loglow/T2M/README.md

See: https://forum.pjrc.com/threads/58795-T2M-an-Embeddable-Teensy-Module-(WIP)
