loglow/T2M/JTAG_Programmer_Assembly.pdf

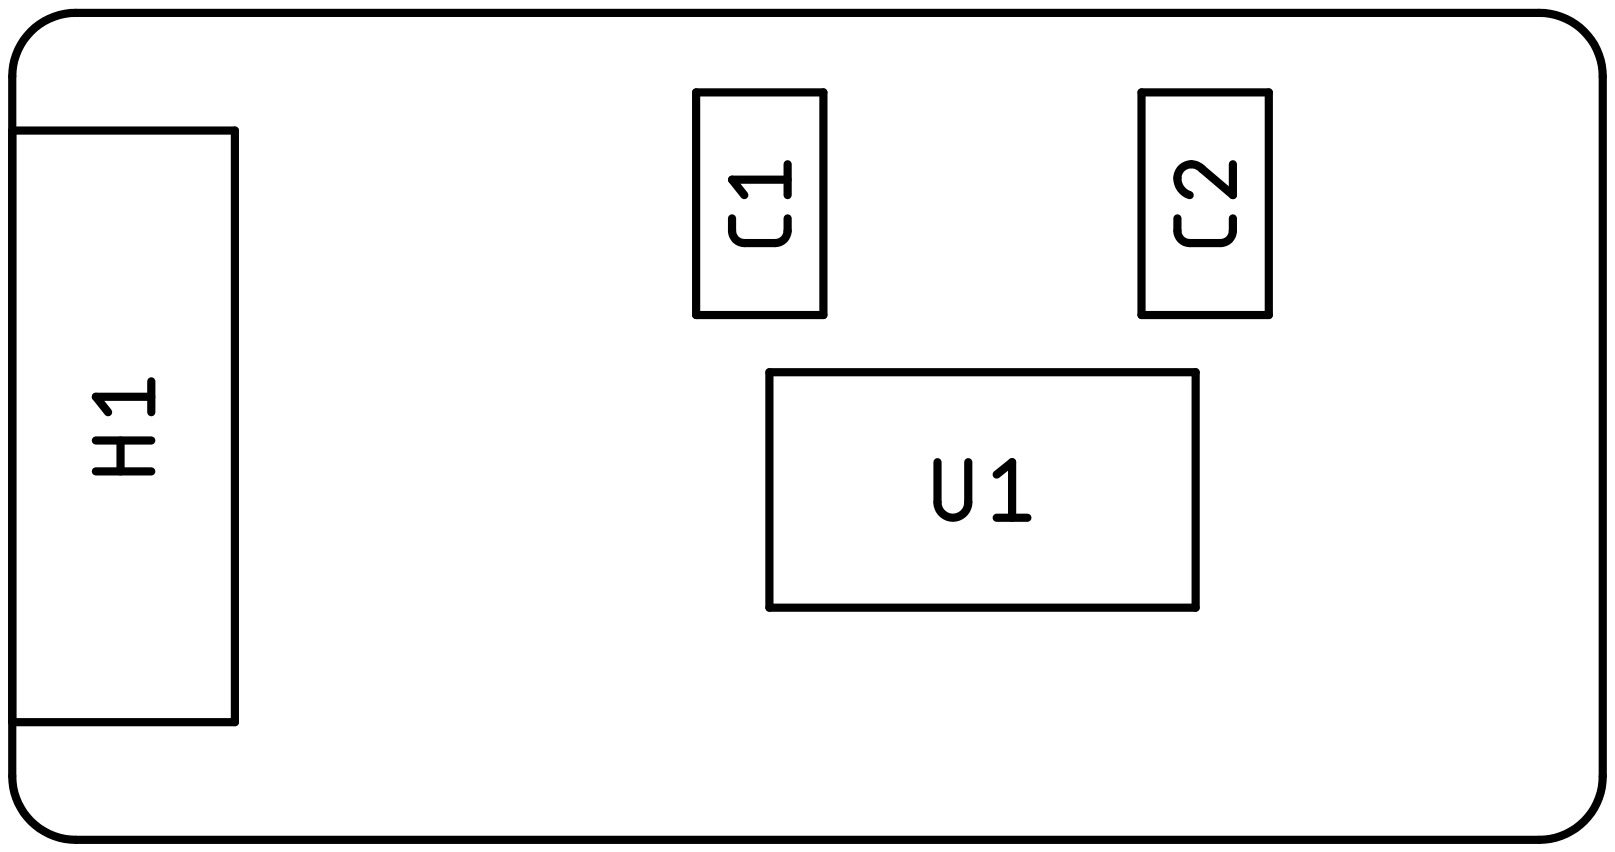
[picture p1: page 1]

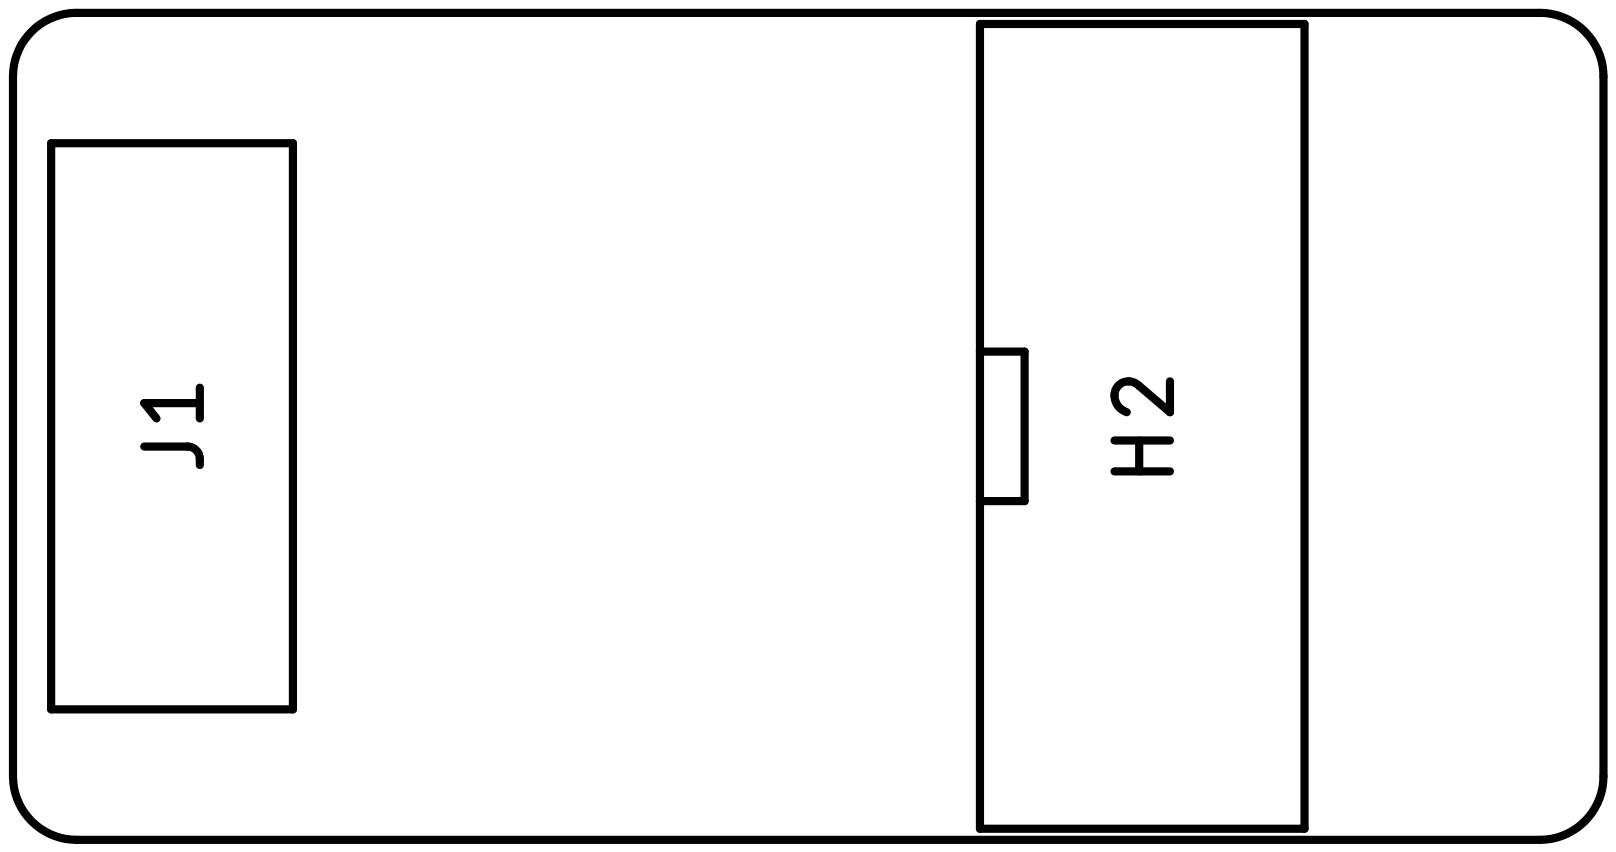
[picture p2: page 2]
