loglow/T2M/MKL02_Programmer_Assembly.pdf

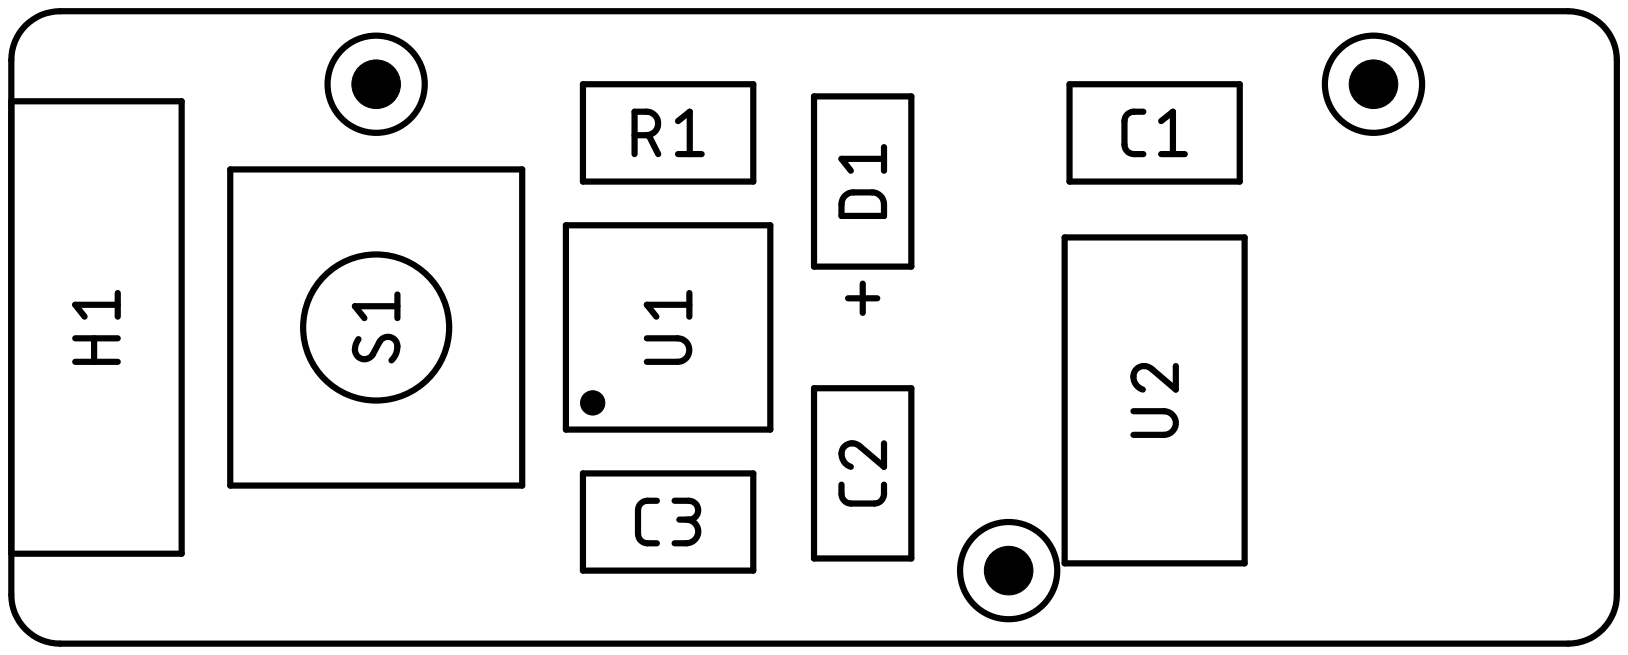
[picture p3: page 1]

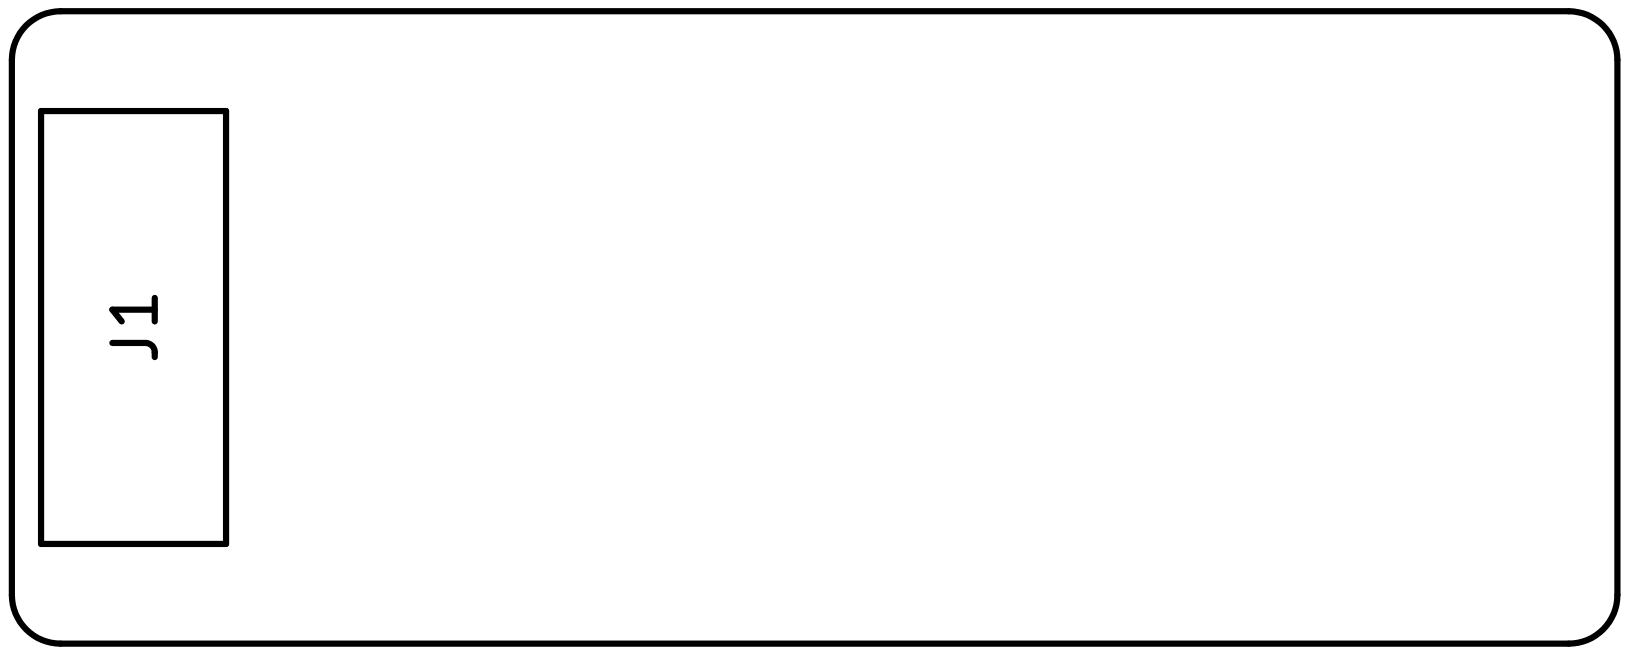
[picture p4: page 2]
