loglow/T2M/T2M_4_0_Assembly.pdf

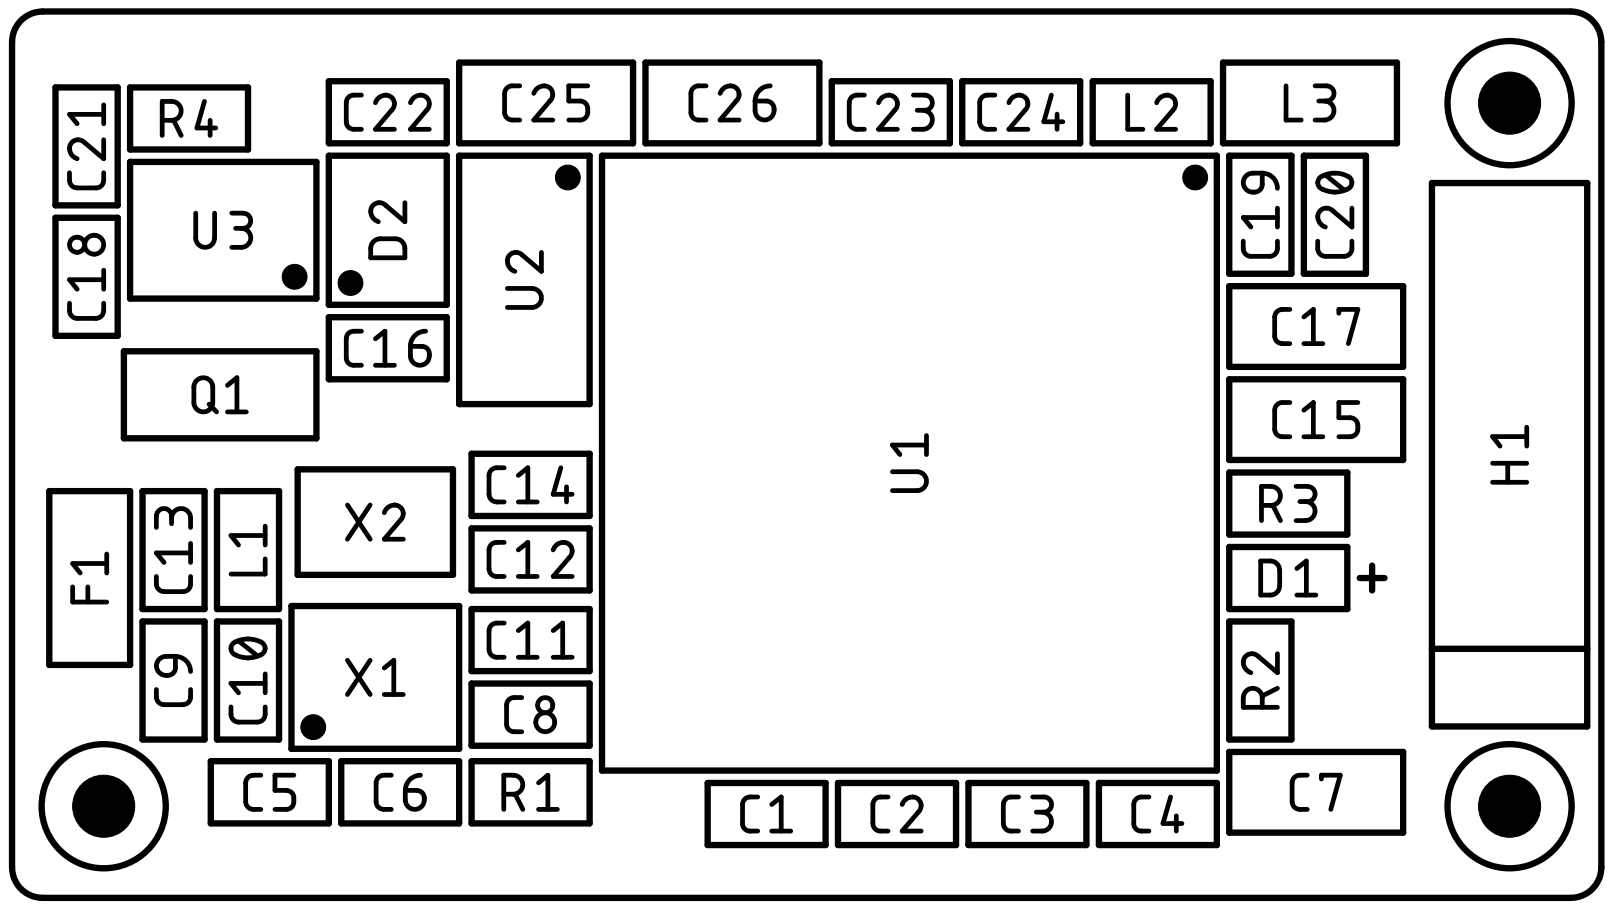
[picture p5: page 1]
