loglow/T2M/JTAG_Programmer.brd

## EAGLE design JTAG_Programmer.brd (2019-12-24)

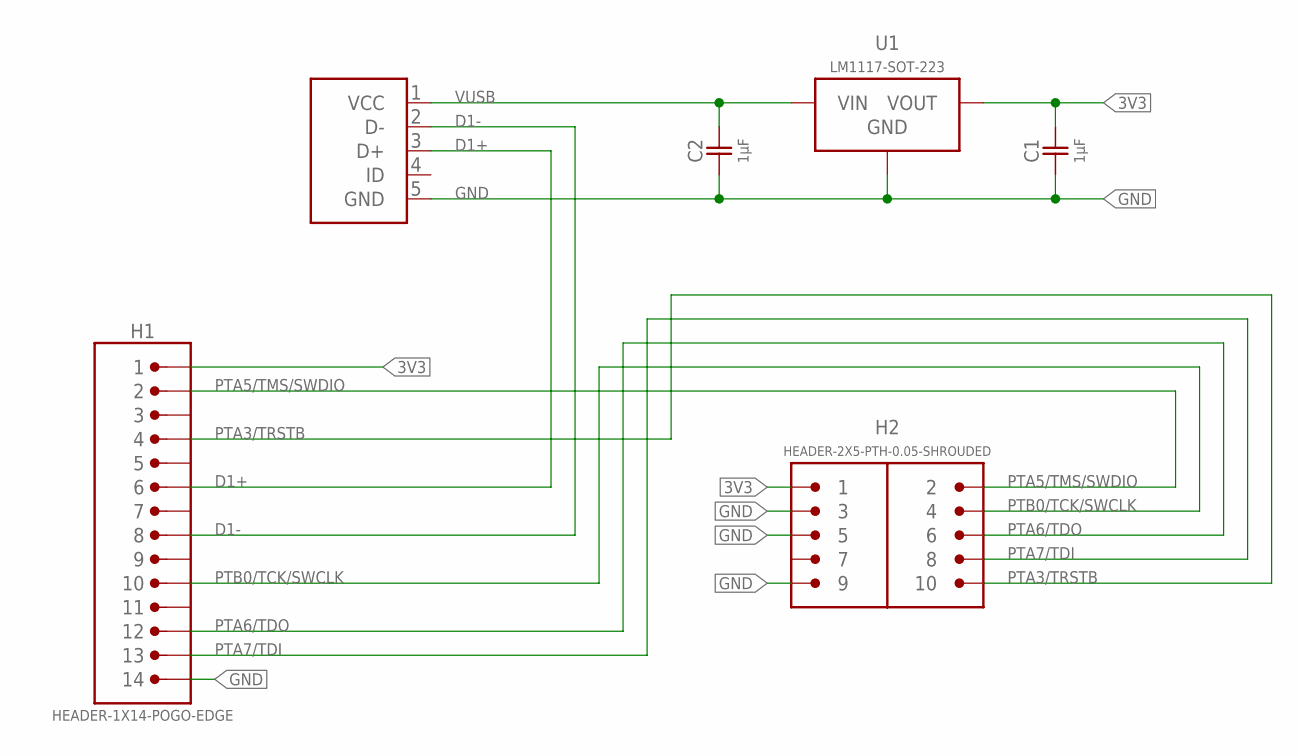
[picture p6: schematic JTAG_Programmer.sch]

Parts:
C1, C2: 1µF; 0805-NP
H1: HEADER-1X14-POGO-EDGE; 2X7-1.27MM-POGO-EDGE
H2: HEADER-2X5-PTH-0.05-SHROUDED; PTH-0.05-2X5-SHROUDED
J1: USB-5-MICRO-B; USB-MICRO-B
U1: LM1117-SOT-223; SOT-223

Connections:
3V3: C1.2, H1.1, H2.1, U1.2 (VOUT), U1.4 (VOUT)
D1+: H1.6, J1.3 (D+)
D1-: H1.8, J1.2 (D-)
GND: C1.1, C2.1, H1.14, H2.3, H2.5, H2.9, J1.5 (GND), U1.1 (GND)
PTA3/TRSTB: H1.4, H2.10
PTA5/TMS/SWDIO: H1.2, H2.2
PTA6/TDO: H1.12, H2.6
PTA7/TDI: H1.13, H2.8
PTB0/TCK/SWCLK: H1.10, H2.4
VUSB: C2.2, J1.1 (VCC), U1.3 (VIN)

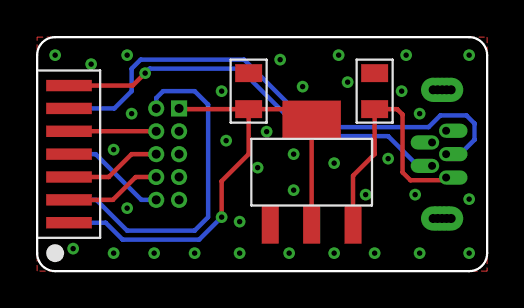
[picture p7: board JTAG_Programmer.brd from above]

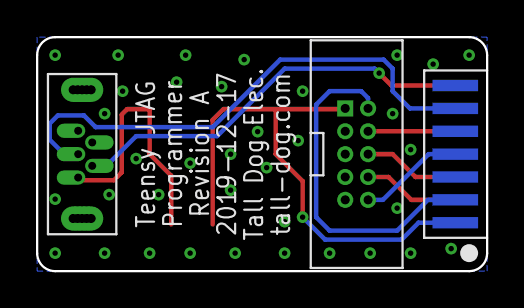
[picture p8: board JTAG_Programmer.brd from below]

Board: 2 copper layers, 25.0 x 13.0 mm, 6 parts (2 on the bottom side), 10 nets.
