loglow/T2M/MKL02_Programmer.brd

## EAGLE design MKL02_Programmer.brd (2019-12-24)

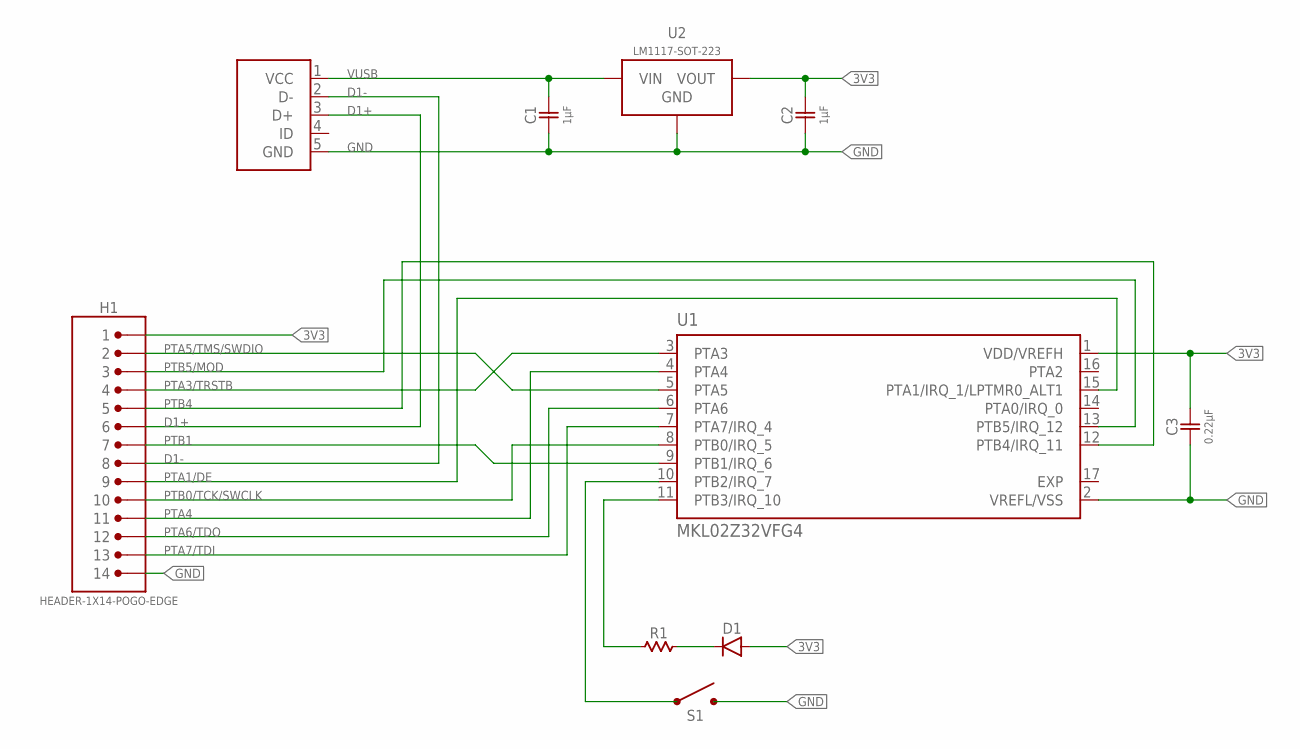
[picture p9: schematic MKL02_Programmer.sch]

Parts:
C1, C2: 1µF; 0805-NP
C3: 0.22µF; 0805-NP
D1: DIODE-0805; 0805-P
H1: HEADER-1X14-POGO-EDGE; 2X7-1.27MM-POGO-EDGE
J1: USB-5-MICRO-B; USB-MICRO-B
R1: RESISTOR-0805; 0805-NP
S1: SPST-6X6; BUTTON-EVQQ2
U1: MKL02Z32VFG4; QFN50P300X300X65-17N
U2: LM1117-SOT-223; SOT-223

Connections:
3V3: C2.2, C3.2, D1.A, H1.1, U1.1 (VDD/VREFH), U2.2 (VOUT), U2.4 (VOUT)
D1+: H1.6, J1.3 (D+)
D1-: H1.8, J1.2 (D-)
EXP: U1.17 (EXP)
GND: C1.1, C2.1, C3.1, H1.14, J1.5 (GND), S1.B1 (2), S1.B2 (2), U1.2 (VREFL/VSS), U2.1 (GND)
unnamed: S1.A1 (1), S1.A2 (1), U1.10 (PTB2/IRQ_7)
unnamed: R1.1, U1.11 (PTB3/IRQ_10)
unnamed: D1.K (C), R1.2
PTA1/DE: H1.9, U1.15 (PTA1/IRQ_1/LPTMR0_ALT1)
PTA3/TRSTB: H1.4, U1.3 (PTA3)
PTA4: H1.11, U1.4 (PTA4)
PTA5/TMS/SWDIO: H1.2, U1.5 (PTA5)
PTA6/TDO: H1.12, U1.6 (PTA6)
PTA7/TDI: H1.13, U1.7 (PTA7/IRQ_4)
PTB0/TCK/SWCLK: H1.10, U1.8 (PTB0/IRQ_5)
PTB1: H1.7, U1.9 (PTB1/IRQ_6)
PTB4: H1.5, U1.12 (PTB4/IRQ_11)
PTB5/MOD: H1.3, U1.13 (PTB5/IRQ_12)
VUSB: C1.2, J1.1 (VCC), U2.3 (VIN)

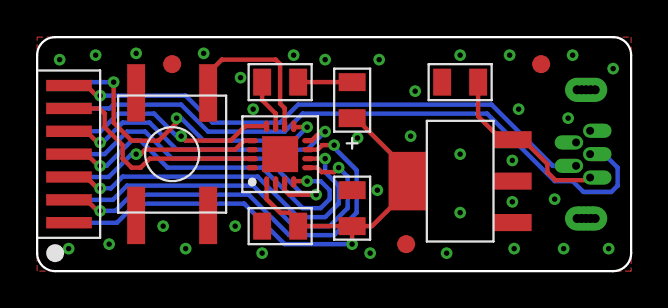
[picture p10: board MKL02_Programmer.brd from above]

Board: 2 copper layers, 33.0 x 13.0 mm, 13 parts (1 on the bottom side), 18 nets.

Other parts of the board:
U$1, U$2, U$3: FIDUCIAL
