loglow/T2M/T2M_4_0.brd

## EAGLE design T2M_4_0.brd (2019-12-24)

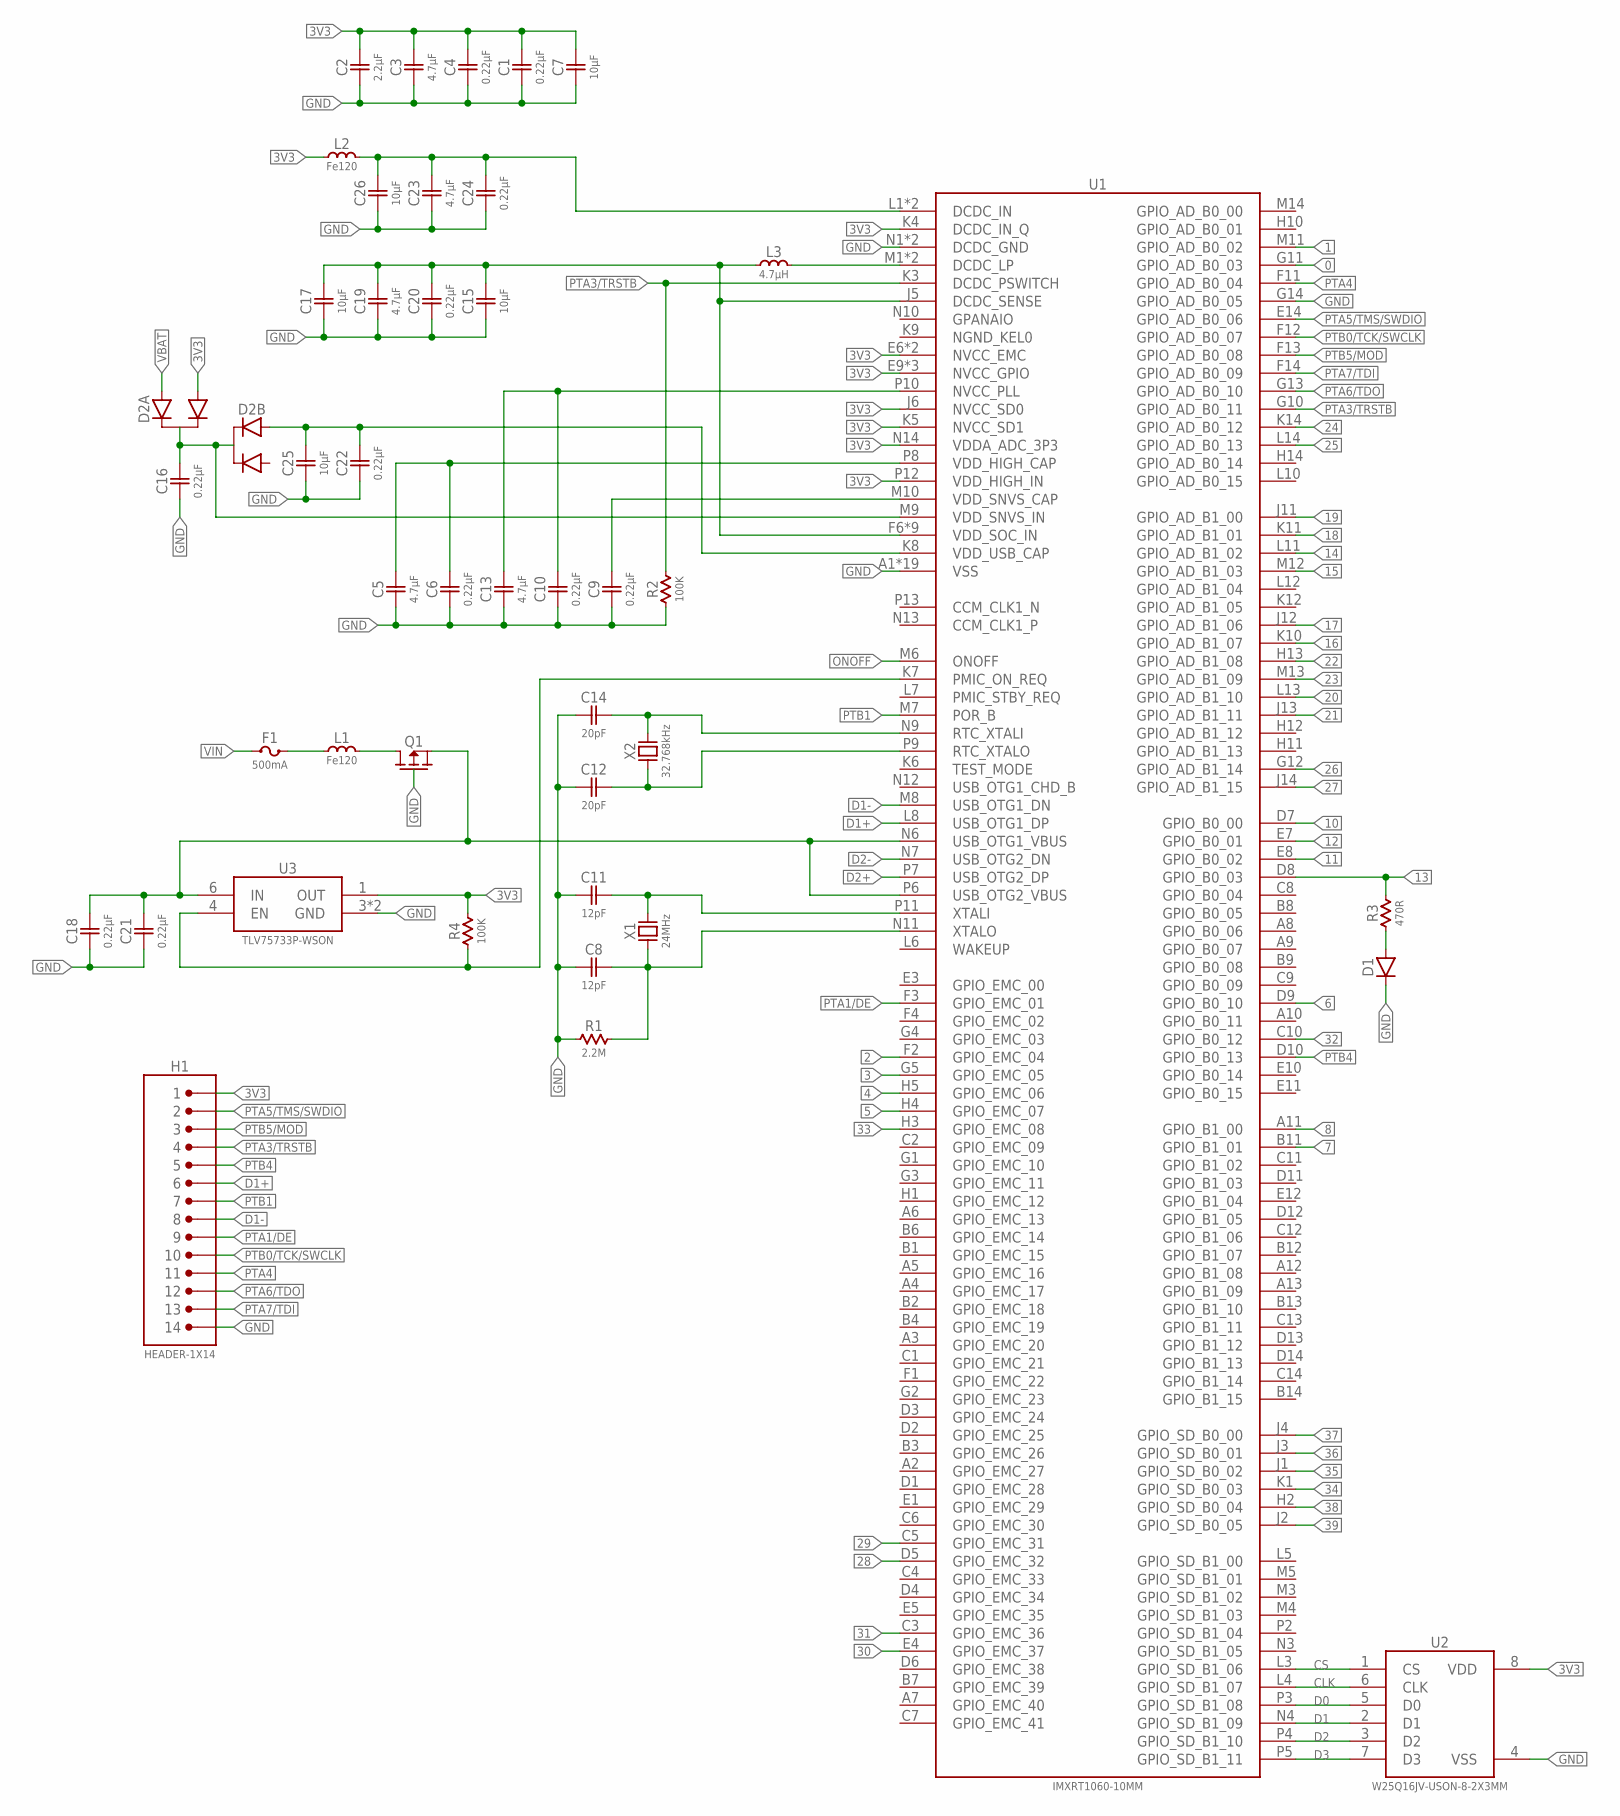
[picture p11: schematic T2M_4_0.sch, sheet 1]

Parts:
C1, C4, C6, C9, C10, C16, C18, C20, C21, C22, C24: 0.22µF; 0402-NP
C2: 2.2µF; 0402-NP
C3, C5, C13, C19, C23: 4.7µF; 0402-NP
C7, C15, C17, C25, C26: 10µF; 0603-NP
C8, C11: 12pF; 0402-NP
C12, C14: 20pF; 0402-NP
D1: DIODE-0402; 0402-P
D2: BAT54C-2-SOT-666; SOT-666
F1: 500mA; 0603-NP
H1: HEADER-1X14; 2X7-1.27MM
L1, L2: Fe120; 0402-NP
L3: 4.7µH; 0603-NP
Q1: MOSFET-P; SOT-23
R1: 2.2M; 0402-NP
R2, R4: 100K; 0402-NP
R3: 470R; 0402-NP
U1: IMXRT1060-10MM; BGA-196-10MM
U2: W25Q16JV-USON-8-2X3MM; USON-8-2X3MM
U3: TLV75733P-WSON; WSON-6
X1: 24MHz; CRYSTAL-2X1.6MM
X2: 32.768kHz; CRYSTAL-2X1.2MM

Connections:
0: U1.G11 (GPIO_AD_B0_03); also elsewhere on the board
1: U1.M11 (GPIO_AD_B0_02); also elsewhere on the board
2: U1.F2 (GPIO_EMC_04); also elsewhere on the board
3: U1.G5 (GPIO_EMC_05); also elsewhere on the board
3V3: C1.2, C2.2, C3.2, C4.2, C7.2, D2.2 (A2), H1.1, L2.1, R4.2, U1.E6 (NVCC_EMC), U1.E9 (NVCC_GPIO), U1.F5 (NVCC_EMC), U1.F10 (NVCC_GPIO), U1.J6 (NVCC_SD0), U1.J10 (NVCC_GPIO), U1.K4 (DCDC_IN_Q), U1.K5 (NVCC_SD1), U1.N14 (VDDA_ADC_3P3), U1.P12 (VDD_HIGH_IN), U2.8 (VDD), U3.1 (OUT); also elsewhere on the board
4: U1.H5 (GPIO_EMC_06); also elsewhere on the board
5: U1.H4 (GPIO_EMC_07); also elsewhere on the board
6: U1.D9 (GPIO_B0_10); also elsewhere on the board
7: U1.B11 (GPIO_B1_01); also elsewhere on the board
8: U1.A11 (GPIO_B1_00); also elsewhere on the board
10: U1.D7 (GPIO_B0_00); also elsewhere on the board
11: U1.E8 (GPIO_B0_02); also elsewhere on the board
12: U1.E7 (GPIO_B0_01); also elsewhere on the board
13: R3.2, U1.D8 (GPIO_B0_03); also elsewhere on the board
14: U1.L11 (GPIO_AD_B1_02); also elsewhere on the board
15: U1.M12 (GPIO_AD_B1_03); also elsewhere on the board
16: U1.K10 (GPIO_AD_B1_07); also elsewhere on the board
17: U1.J12 (GPIO_AD_B1_06); also elsewhere on the board
18: U1.K11 (GPIO_AD_B1_01); also elsewhere on the board
19: U1.J11 (GPIO_AD_B1_00); also elsewhere on the board
20: U1.L13 (GPIO_AD_B1_10); also elsewhere on the board
21: U1.J13 (GPIO_AD_B1_11); also elsewhere on the board
22: U1.H13 (GPIO_AD_B1_08); also elsewhere on the board
23: U1.M13 (GPIO_AD_B1_09); also elsewhere on the board
24: U1.K14 (GPIO_AD_B0_12); also elsewhere on the board
25: U1.L14 (GPIO_AD_B0_13); also elsewhere on the board
26: U1.G12 (GPIO_AD_B1_14); also elsewhere on the board
27: U1.J14 (GPIO_AD_B1_15); also elsewhere on the board
28: U1.D5 (GPIO_EMC_32); also elsewhere on the board
29: U1.C5 (GPIO_EMC_31); also elsewhere on the board
30: U1.E4 (GPIO_EMC_37); also elsewhere on the board
31: U1.C3 (GPIO_EMC_36); also elsewhere on the board
32: U1.C10 (GPIO_B0_12); also elsewhere on the board
33: U1.H3 (GPIO_EMC_08); also elsewhere on the board
34: U1.K1 (GPIO_SD_B0_03); also elsewhere on the board
35: U1.J1 (GPIO_SD_B0_02); also elsewhere on the board
36: U1.J3 (GPIO_SD_B0_01); also elsewhere on the board
37: U1.J4 (GPIO_SD_B0_00); also elsewhere on the board
38: U1.H2 (GPIO_SD_B0_04); also elsewhere on the board
39: U1.J2 (GPIO_SD_B0_05); also elsewhere on the board
CLK: U1.L4 (GPIO_SD_B1_07), U2.6 (CLK)
CS: U1.L3 (GPIO_SD_B1_06), U2.1 (CS)
D0: U1.P3 (GPIO_SD_B1_08), U2.5 (D0)
D1: U1.N4 (GPIO_SD_B1_09), U2.2 (D1)
D1+: H1.6, U1.L8 (USB_OTG1_DP); also elsewhere on the board
D1-: H1.8, U1.M8 (USB_OTG1_DN); also elsewhere on the board
D2: U1.P4 (GPIO_SD_B1_10), U2.3 (D2)
D2+: U1.P7 (USB_OTG2_DP); also elsewhere on the board
D2-: U1.N7 (USB_OTG2_DN); also elsewhere on the board
D3: U1.P5 (GPIO_SD_B1_11), U2.7 (D3)
GND: C1.1, C2.1, C3.1, C4.1, C5.1, C6.1, C7.1, C8.1, C9.1, C10.1, C11.1, C12.1, C13.1, C14.1, C15.1, C16.1, C17.1, C18.1, C19.1, C20.1, C21.1, C22.1, C23.1, C24.1, C25.1, C26.1, D1.C, H1.14, Q1.1 (G), R1.1, R2.1, U1.A1 (VSS), U1.A14 (VSS), U1.B5 (VSS), U1.B10 (VSS), U1.E2 (VSS), U1.E13 (VSS), U1.G7 (VSS), U1.G8 (VSS), U1.G14 (GPIO_AD_B0_05), U1.H7 (VSS), U1.H8 (VSS), U1.J7 (VSS), U1.J8 (VSS), U1.K2 (VSS), U1.K13 (VSS), U1.L9 (VSS), U1.N1 (DCDC_GND), U1.N2 (DCDC_GND), U1.N5 (VSS), U1.N8 (VSS), U1.P1 (VSS), U1.P14 (VSS), U2.4 (VSS), U3.3 (GND), U3.7 (GND); also elsewhere on the board
unnamed: C11.2, U1.P11 (XTALI), X1.3 (2)
unnamed: C8.2, R1.2, U1.N11 (XTALO), X1.1
unnamed: C14.2, U1.N9 (RTC_XTALI), X2.2
unnamed: C12.2, U1.P9 (RTC_XTALO), X2.1
unnamed: D1.A, R3.1
unnamed: C18.2, C21.2, Q1.2 (S), U1.N6 (USB_OTG1_VBUS), U1.P6 (USB_OTG2_VBUS), U3.6 (IN)
unnamed: R4.1, U1.K7 (PMIC_ON_REQ), U3.4 (EN)
unnamed: C22.2, C25.2, D2.4 (A1), U1.K8 (VDD_USB_CAP)
unnamed: L3.2, U1.M1 (DCDC_LP), U1.M2 (DCDC_LP)
unnamed: C23.2, C24.2, C26.2, L2.2, U1.L1 (DCDC_IN), U1.L2 (DCDC_IN)
unnamed: C15.2, C17.2, C19.2, C20.2, L3.1, U1.F6 (VDD_SOC_IN), U1.F7 (VDD_SOC_IN), U1.F8 (VDD_SOC_IN), U1.F9 (VDD_SOC_IN), U1.G6 (VDD_SOC_IN), U1.G9 (VDD_SOC_IN), U1.H6 (VDD_SOC_IN), U1.H9 (VDD_SOC_IN), U1.J5 (DCDC_SENSE), U1.J9 (VDD_SOC_IN)
unnamed: C16.2, D2.3 (CC), D2.6 (CC), U1.M9 (VDD_SNVS_IN)
unnamed: L1.2, Q1.3 (D)
unnamed: F1.2, L1.1
unnamed: C5.2, C6.2, U1.P8 (VDD_HIGH_CAP)
unnamed: C10.2, C13.2, U1.P10 (NVCC_PLL)
unnamed: C9.2, U1.M10 (VDD_SNVS_CAP)
ONOFF: U1.M6 (ONOFF); also elsewhere on the board
PTA1/DE: H1.9, U1.F3 (GPIO_EMC_01); also elsewhere on the board
PTA3/TRSTB: H1.4, R2.2, U1.G10 (GPIO_AD_B0_11), U1.K3 (DCDC_PSWITCH); also elsewhere on the board
PTA4: H1.11, U1.F11 (GPIO_AD_B0_04); also elsewhere on the board
PTA5/TMS/SWDIO: H1.2, U1.E14 (GPIO_AD_B0_06); also elsewhere on the board
PTA6/TDO: H1.12, U1.G13 (GPIO_AD_B0_10); also elsewhere on the board
PTA7/TDI: H1.13, U1.F14 (GPIO_AD_B0_09); also elsewhere on the board
PTB0/TCK/SWCLK: H1.10, U1.F12 (GPIO_AD_B0_07); also elsewhere on the board
PTB1: H1.7, U1.M7 (POR_B); also elsewhere on the board
PTB4: H1.5, U1.D10 (GPIO_B0_13); also elsewhere on the board
PTB5/MOD: H1.3, U1.F13 (GPIO_AD_B0_08); also elsewhere on the board
VBAT: D2.1 (A1); also elsewhere on the board
VIN: F1.1; also elsewhere on the board

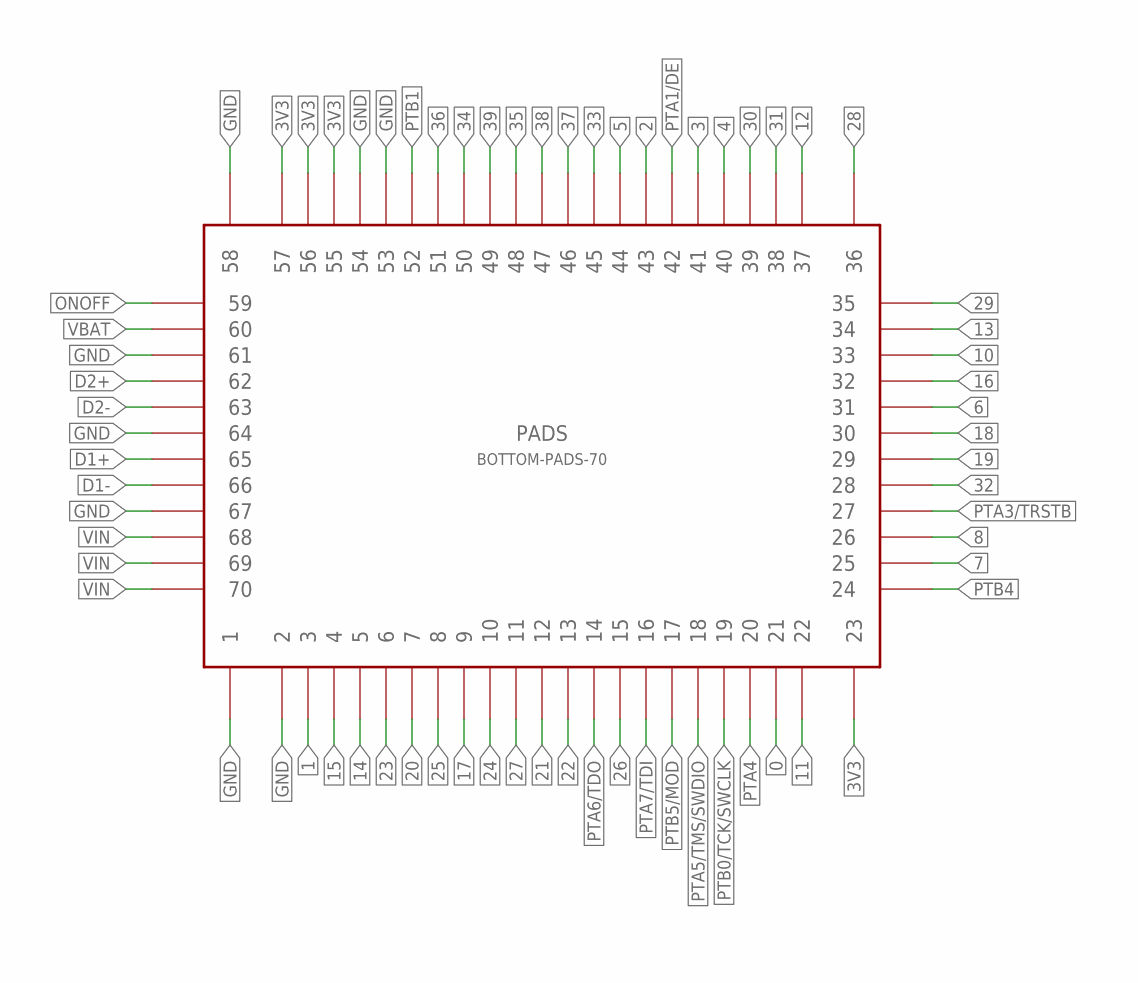
[picture p12: schematic T2M_4_0.sch, sheet 2]

Parts:
PADS: BOTTOM-PADS-70

Connections:
0: PADS.21; also elsewhere on the board
1: PADS.3; also elsewhere on the board
2: PADS.43; also elsewhere on the board
3: PADS.41; also elsewhere on the board
3V3: PADS.23, PADS.55, PADS.56, PADS.57; also elsewhere on the board
4: PADS.40; also elsewhere on the board
5: PADS.44; also elsewhere on the board
6: PADS.31; also elsewhere on the board
7: PADS.25; also elsewhere on the board
8: PADS.26; also elsewhere on the board
10: PADS.33; also elsewhere on the board
11: PADS.22; also elsewhere on the board
12: PADS.37; also elsewhere on the board
13: PADS.34; also elsewhere on the board
14: PADS.5; also elsewhere on the board
15: PADS.4; also elsewhere on the board
16: PADS.32; also elsewhere on the board
17: PADS.9; also elsewhere on the board
18: PADS.30; also elsewhere on the board
19: PADS.29; also elsewhere on the board
20: PADS.7; also elsewhere on the board
21: PADS.12; also elsewhere on the board
22: PADS.13; also elsewhere on the board
23: PADS.6; also elsewhere on the board
24: PADS.10; also elsewhere on the board
25: PADS.8; also elsewhere on the board
26: PADS.15; also elsewhere on the board
27: PADS.11; also elsewhere on the board
28: PADS.36; also elsewhere on the board
29: PADS.35; also elsewhere on the board
30: PADS.39; also elsewhere on the board
31: PADS.38; also elsewhere on the board
32: PADS.28; also elsewhere on the board
33: PADS.45; also elsewhere on the board
34: PADS.50; also elsewhere on the board
35: PADS.48; also elsewhere on the board
36: PADS.51; also elsewhere on the board
37: PADS.46; also elsewhere on the board
38: PADS.47; also elsewhere on the board
39: PADS.49; also elsewhere on the board
D1+: PADS.65; also elsewhere on the board
D1-: PADS.66; also elsewhere on the board
D2+: PADS.62; also elsewhere on the board
D2-: PADS.63; also elsewhere on the board
GND: PADS.1, PADS.2, PADS.53, PADS.54, PADS.58, PADS.61, PADS.64, PADS.67; also elsewhere on the board
ONOFF: PADS.59; also elsewhere on the board
PTA1/DE: PADS.42; also elsewhere on the board
PTA3/TRSTB: PADS.27; also elsewhere on the board
PTA4: PADS.20; also elsewhere on the board
PTA5/TMS/SWDIO: PADS.18; also elsewhere on the board
PTA6/TDO: PADS.14; also elsewhere on the board
PTA7/TDI: PADS.16; also elsewhere on the board
PTB0/TCK/SWCLK: PADS.19; also elsewhere on the board
PTB1: PADS.52; also elsewhere on the board
PTB4: PADS.24; also elsewhere on the board
PTB5/MOD: PADS.17; also elsewhere on the board
VBAT: PADS.60; also elsewhere on the board
VIN: PADS.68, PADS.69, PADS.70; also elsewhere on the board

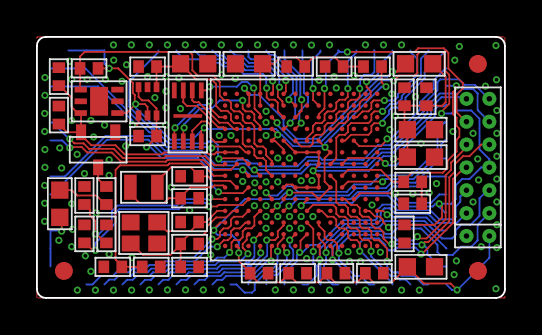
[picture p13: board T2M_4_0.brd from above]

Board: 2 copper layers, 26.0 x 14.5 mm, 47 parts (0 on the bottom side), 81 nets.

Other parts of the board:
FID1, FID2, FID3: FIDUCIAL
